shilga/rp2040-gameboy-cartridge/KiCad/V1/GameboyCartridgeV1.1/GameboyCartridgeV1.1.png

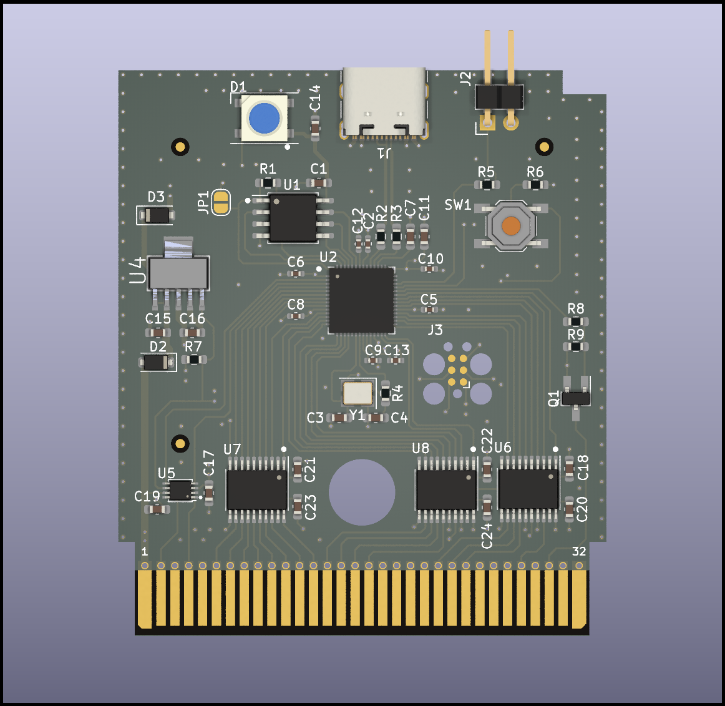
KiCad/V1/GameboyCartridgeV1.1/GameboyCartridgeV1.1.png
