shilga/rp2040-gameboy-cartridge/KiCad/V1/GameboyCartridgeV1.1/GameboyCartridgeV1.1_schematic.pdf

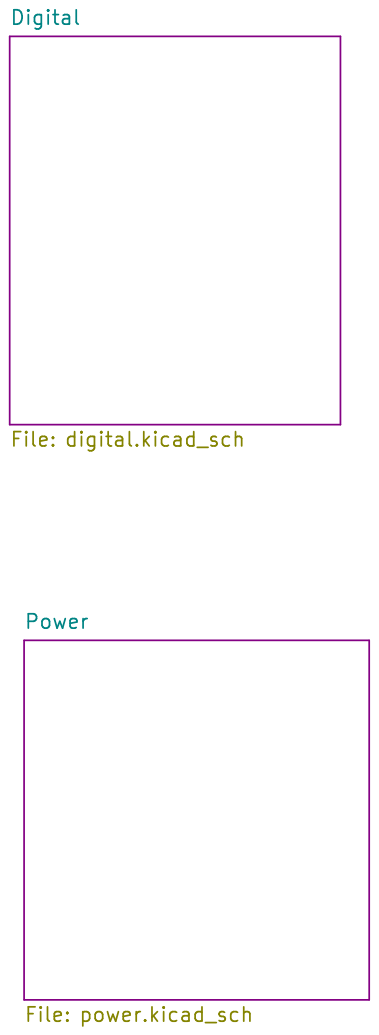
[picture p2: page 1]

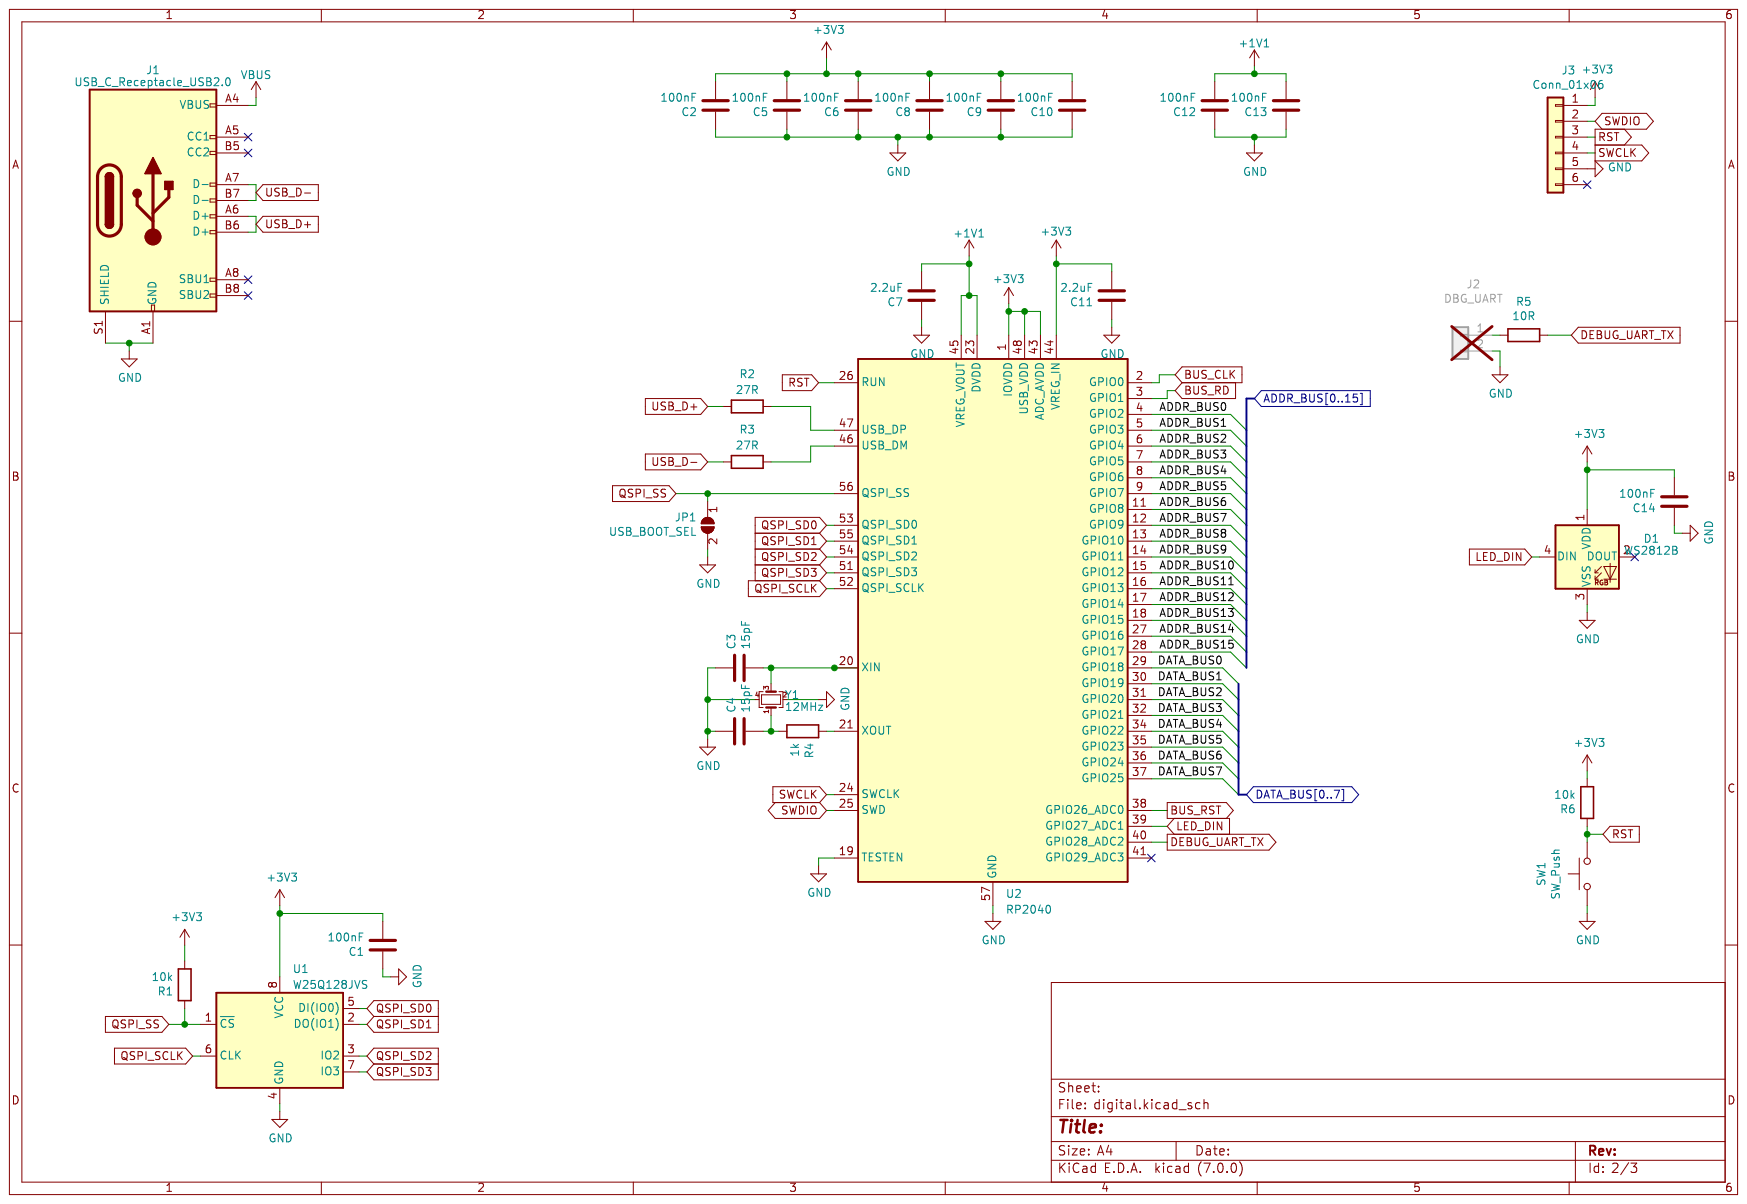
[picture p3: page 2]

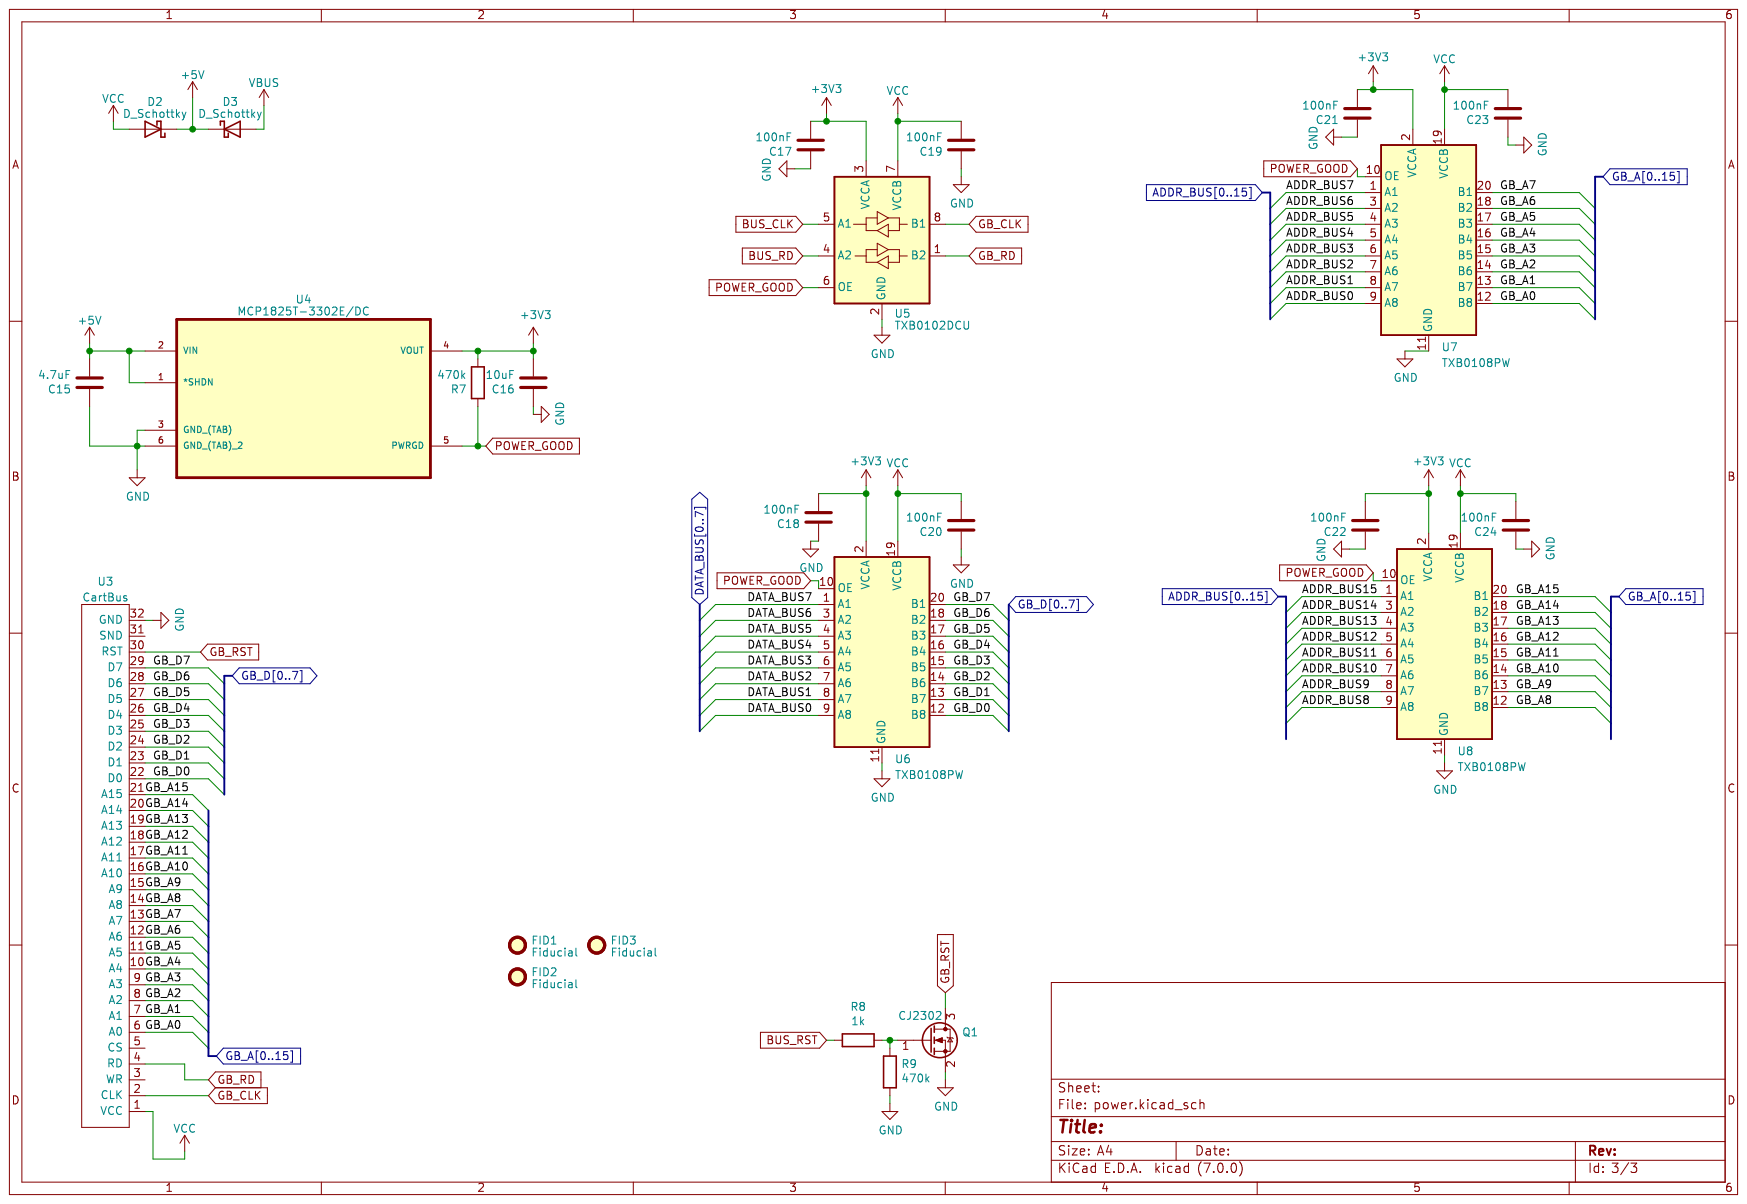
[picture p4: page 3]
