shilga/rp2040-gameboy-cartridge/(threads)

Thread 1 (2024-02-23):

is 4 layer board necessary?

gezzerlol, 2024-02-23:
I see that the layout has 4 layers and 2 of the layers are pretty empty. is there any specific reason for me not to do route the board in only 2 layers? And is it okay if I create a pull request for a 2 layer alternative layout once I get it to work?

shilga, 2024-02-26:
I created it in 4 layers because of EMV reasons and also because routed power would be rather complicated. Actually it's also not that much more expensive than the 2 layers. It's a lot more expensive to have ENIG finish for the edge connector. Otherwise the connector will break after a few connection attempts. Also shipping is a also more expensive.

Actually looking through JLCPCB currently getting 4 layers with ENIG is 29$ while 2 layers with ENIG is 33$. For 10 PCBs each. So no reason to not use 4 layers in my opinion.

gezzerlol, 2024-02-26:
I already ordered my pcb's with 1oz copper and HASL surface finish... let's see how it goes. I also routed the pcb for 2 layers, the power routing wasn't complicated at all, if I didn't make an obvious mistake.
Here is the back layer, didn't do much changes on the front copper layer:
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

shilga, 2024-02-26:
Indeed looks quite simple to use only 2 layers. Originally I created version 1.0 just for fun for me. As some friends wanted to have one of those cartridges I thought I could sell them on Tindie too. I created version 1.1 as I ran out of PCBs and some parts had not been available anymore half a year later. But I needed to fulfil the orders and I did not change anything else to just order new ones. I think more money can be saved in assembly by using cheaper parts and basic-parts with JLCPCB. I see you did that in your fork.

It would be interesting to check the EMC differences between the 2 and 4 layers. I setup the push-pull pins with the highest drive-strength as the signal timings are really tight. That could emit quite some noise. Sadly I don't have equipment to test this.

Would be nice if you could report on the stability of the HASL edge connector.

Yes 2$ is cheap, but 4 layers is 7$ for 5 pieces. Shipping + taxes is 20$. Stencil is another 7$. Those 5$ extra for 4 layers is for most of my prototypes not worth the effort to do the hassle of 2 layers. Especially if there is a lot less space than on this PCB. That is why I just created it with 4 layers.

BTW, did you also remove the ESD protection and the fuse on the USB?
